rishigovindnair-web/mini-bluetooth-speaker/BOM.csv

Item | Part | Qty used | Pack size | Role | Must-match spec | Example source | Link | Approx price (USD) | CAD file | Notes
1 | Li-ion cell 18650 (Samsung INR18650-25R) | 1 | 1 | Battery | Flat-top, unprotected, max 18.4 x 65.0 mm | 18650BatteryStore (US) | https://www.18650batterystore.com/products/samsung-25r-18650 | 4.99 | cad/reference/05_cell_samsung_INR18650-25R.step | Buy cells from a battery dealer, not a marketplace: fakes with inflated capacity are common. Store ships in the US for about $5.
2 | Bluetooth amp board MH-M38 | 1 | 1 | Bluetooth receiver + 2 x 5 W amp | Must be the M38 (M18 and M28 have no amp). About 45 x 20 mm; the pocket is 45.6 x 20.6 mm | AliExpress (EGBO Store) | https://www.aliexpress.us/item/3256808177096535.html | 1.66 | cad/reference/03_amp_board_DFR0720_MH-M38.step | Pick the variant "M38 MICRO". The CAD is modelled on the DFRobot DFR0720, which is the same MH-M38 module.
3 | TP4056 USB-C charger with protection | 1 | 5 | Charging + battery protection | USB-C, about 28 x 17 mm, three chips on the board: TP4056 + DW01A + 8205A | AliExpress (Great IT electronic components) | https://www.aliexpress.us/item/2251832744326141.html | 1.83 | cad/reference/06_charger_module_TP4056_USB-C.step | Pick the variant "5PCS 18650 type-c". A board with only one chip has no battery protection; do not use it with this cell.
4 | Speaker driver 40 mm 4 ohm 3 W | 1 | 2 | Full-range driver | Round, 40 mm diameter, 20 mm tall or less, 4 ohm | AliExpress (Stationery world Store) | https://www.aliexpress.us/item/3256807819452623.html | 4.95 | cad/reference/04_driver_40mm_adafruit_3968.step | The seller's drawing shows 40 x 19 mm. Anything taller than 20 mm hits the cell. The second driver is a spare.
5 | Nickel strip 0.15 x 8 mm | 50 mm (two 25 mm tabs) | 10 m | Cell tabs | Pure nickel, 0.15 mm thick, 8 mm wide | AliExpress (Global-Dropshipping Store) | https://www.aliexpress.us/item/3256811494411014.html | 5.05 | cad/reference/08_nickel_tab_0.15x8x25mm.step | Pick the variant "0.15mm". Nickel-plated steel is cheaper but takes solder badly. Spot-weld the tabs to the cell.
6 | M2 x 8 mm self-tapping screws | 4 | 50 | Lid screws | M2, 8 mm long, self-tapping, head no wider than 4.2 mm | AliExpress (TINGGOO Official Store) | https://www.aliexpress.us/item/3256807588372372.html | 1.80 | cad/reference/07_screw_M2x8_self-tapping.step | Pick the variant "8mm/50pcs M2". The lid recesses are 4.4 mm across; if the heads are wider, use any M2 x 8 pan-head self-tapper instead.
7 | Slide switch SS12D00G4 | 1 | 50 | Power switch | SPDT, body about 8.6 x 3.6 x 3.5 mm, 4 mm lever | AliExpress | https://www.aliexpress.us/item/3256809209016852.html | 1.27 | cad/reference/09_slide_switch_SS12D00G4.step | Pick the variant "Handle length 4mm". It sits in the recess on the inside of the end wall with the lever through the slot.
8 | PLA or PETG filament | about 60 g |  | Enclosure | 1.75 mm | Any |  |  | cad/print/01_enclosure_base.stl; cad/print/02_enclosure_lid.stl | Base and lid are 56 cm3 of plastic if printed solid, so a normal print uses less.
9 | Hook-up wire 26-28 AWG | about 30 cm |  | Internal wiring | Stranded, red and black | Any
10 | Hot glue | a few sticks |  | Holds the boards and switch; seals the driver |  | Any
