rishigovindnair-web/mini-bluetooth-speaker/cad/assembly/00_full_assembly.step

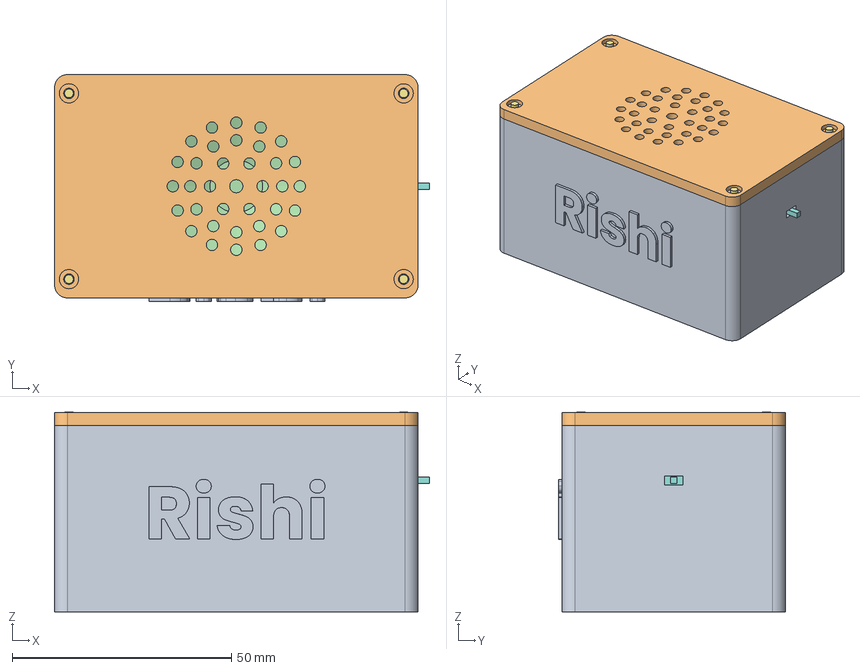
[picture p4: CAD file, 2026-10-26]
cad/assembly/00_full_assembly.step
85.6 x 51.8 x 45.6 mm
01_enclosure_base
02_enclosure_lid
03_amp_board_DFR0720_MH-M38
04_driver_40mm_adafruit_3968
05_cell_samsung_INR18650-25R
06_charger_module_TP4056_USB-C
07_screw_M2x8_1
07_screw_M2x8_2
07_screw_M2x8_3
07_screw_M2x8_4
09_slide_switch_SS12D00G4
