rishigovindnair-web/mini-bluetooth-speaker/cad/assembly/00_layout_flat_all_parts.step

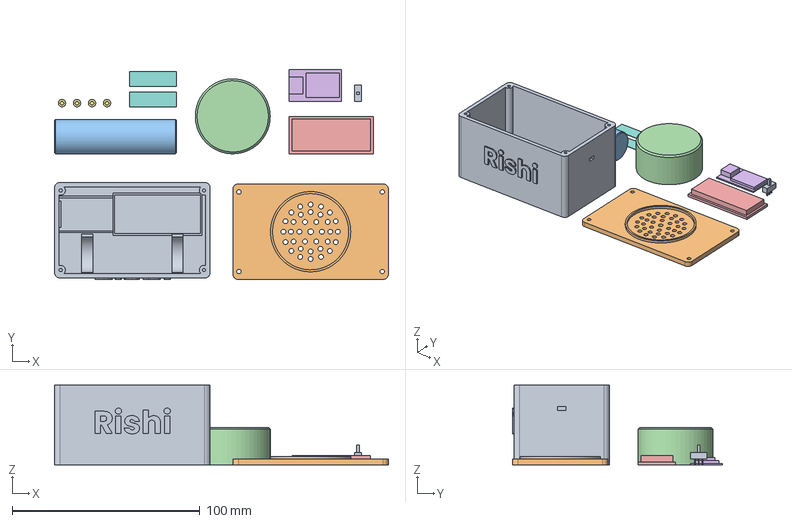
[picture p5: CAD file, 2026-10-26]
cad/assembly/00_layout_flat_all_parts.step
178.0 x 112.0 x 42.5 mm
01_enclosure_base
02_enclosure_lid_flipped
05_cell_samsung_INR18650-25R
04_driver_40mm_face_up
03_amp_board_DFR0720_MH-M38
06_charger_module_TP4056_USB-C
07_screw_M2x8_1
07_screw_M2x8_2
07_screw_M2x8_3
07_screw_M2x8_4
08_nickel_tab_25mm_1
08_nickel_tab_25mm_2
09_slide_switch_SS12D00G4
