rishigovindnair-web/mini-bluetooth-speaker/cad/print/02_enclosure_lid.step

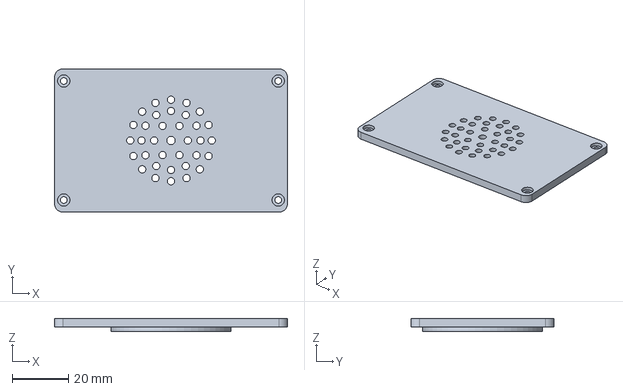
[picture p6: CAD file, 2026-10-26]
cad/print/02_enclosure_lid.step
83.0 x 51.0 x 4.50 mm
