rishigovindnair-web/mini-bluetooth-speaker/cad/reference/08_nickel_tab_0.15x8x25mm.step

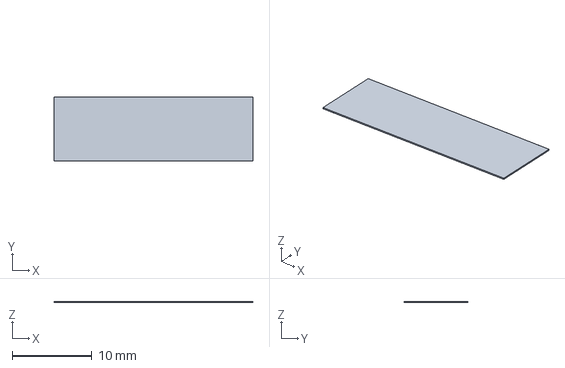
[picture p7: CAD file, 2026-10-26]
cad/reference/08_nickel_tab_0.15x8x25mm.step
25.0 x 8.00 x 0.15 mm
