rishigovindnair-web/mini-bluetooth-speaker/cad/print/01_enclosure_base.step

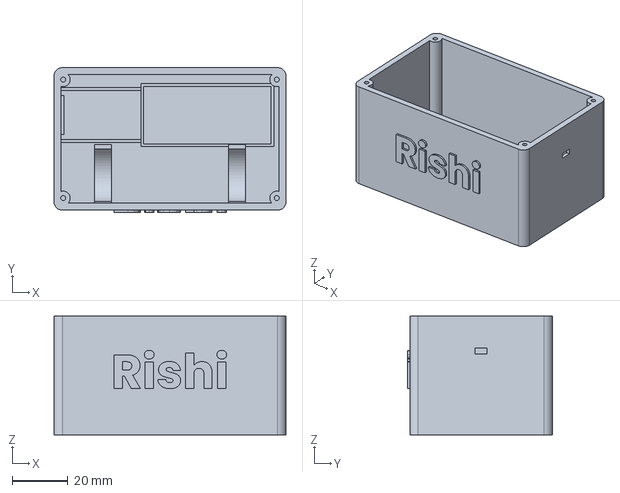
[picture p8: CAD file, 2026-10-26]
cad/print/01_enclosure_base.step
83.0 x 51.8 x 42.5 mm
