rishigovindnair-web/mini-bluetooth-speaker/cad/reference/03_amp_board_DFR0720_MH-M38.step

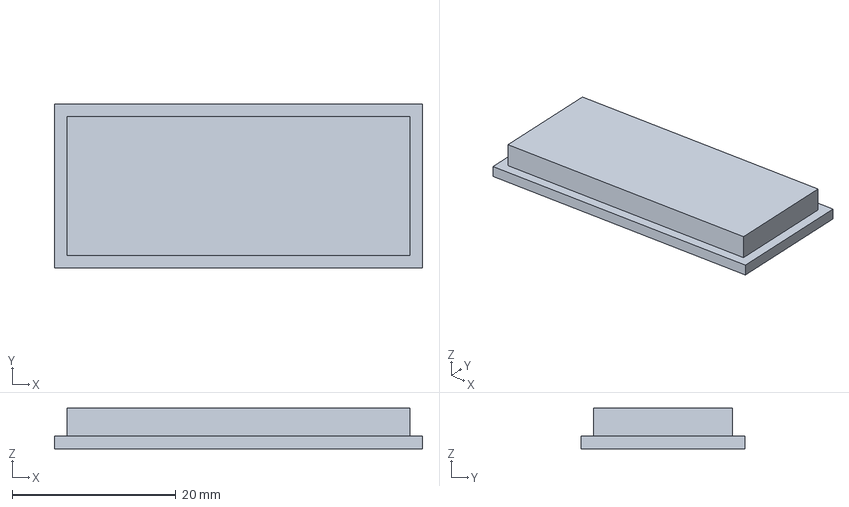
[picture p9: CAD file, 2026-10-26]
cad/reference/03_amp_board_DFR0720_MH-M38.step
45.0 x 20.0 x 5.00 mm
