rishigovindnair-web/mini-bluetooth-speaker/cad/reference/05_cell_samsung_INR18650-25R.step

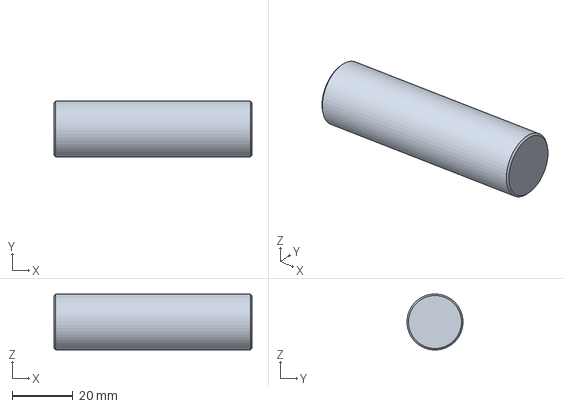
[picture p10: CAD file, 2026-10-26]
cad/reference/05_cell_samsung_INR18650-25R.step
65.0 x 18.4 x 18.4 mm
