rishigovindnair-web/mini-bluetooth-speaker/cad/reference/06_charger_module_TP4056_USB-C.step

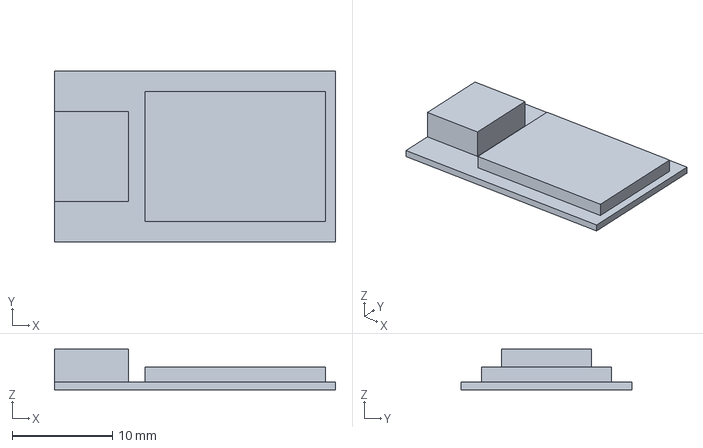
[picture p11: CAD file, 2026-10-26]
cad/reference/06_charger_module_TP4056_USB-C.step
28.0 x 17.0 x 4.06 mm
