rishigovindnair-web/mini-bluetooth-speaker/cad/reference/09_slide_switch_SS12D00G4.step

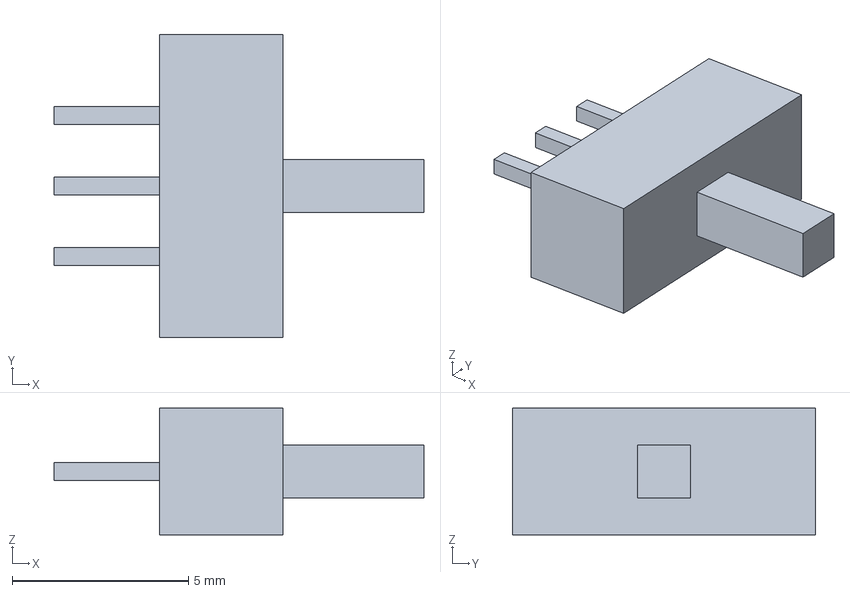
[picture p12: CAD file, 2026-10-26]
cad/reference/09_slide_switch_SS12D00G4.step
10.5 x 8.60 x 3.60 mm
