rishigovindnair-web/mini-bluetooth-speaker/cad/reference/04_driver_40mm_adafruit_3968.step

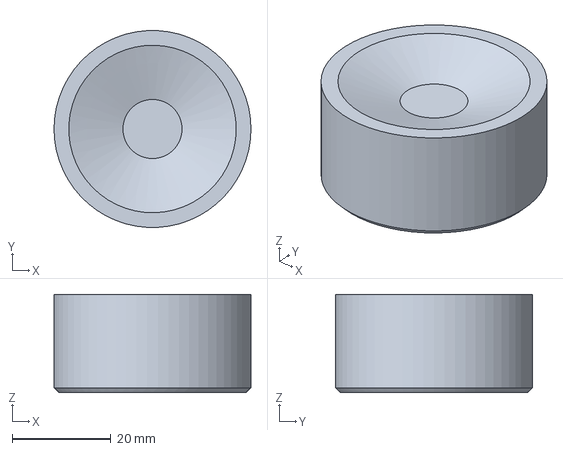
[picture p13: CAD file, 2026-10-26]
cad/reference/04_driver_40mm_adafruit_3968.step
40.0 x 39.9 x 20.0 mm
