rishigovindnair-web/mini-bluetooth-speaker/cad/reference/07_screw_M2x8_self-tapping.step

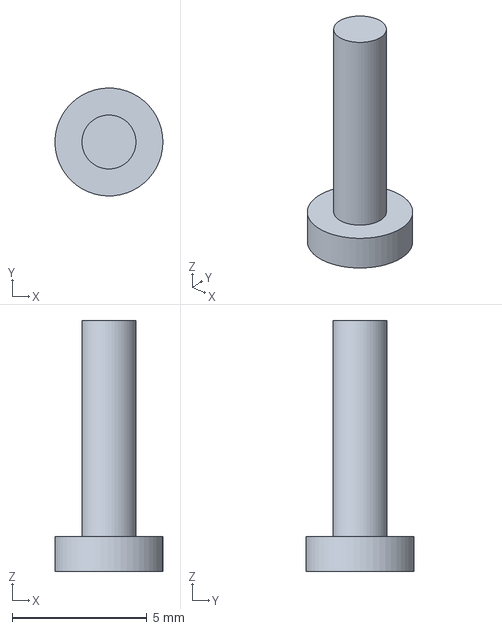
[picture p14: CAD file, 2026-10-26]
cad/reference/07_screw_M2x8_self-tapping.step
4.00 x 4.00 x 9.30 mm
