rishigovindnair-web/mini-bluetooth-speaker/(list of files, cad)

Other CAD files:
cad/print/01_enclosure_base.stl
cad/print/02_enclosure_lid.stl
