rishigovindnair-web/mini-bluetooth-speaker/hardware/wiring_schematic.pdf

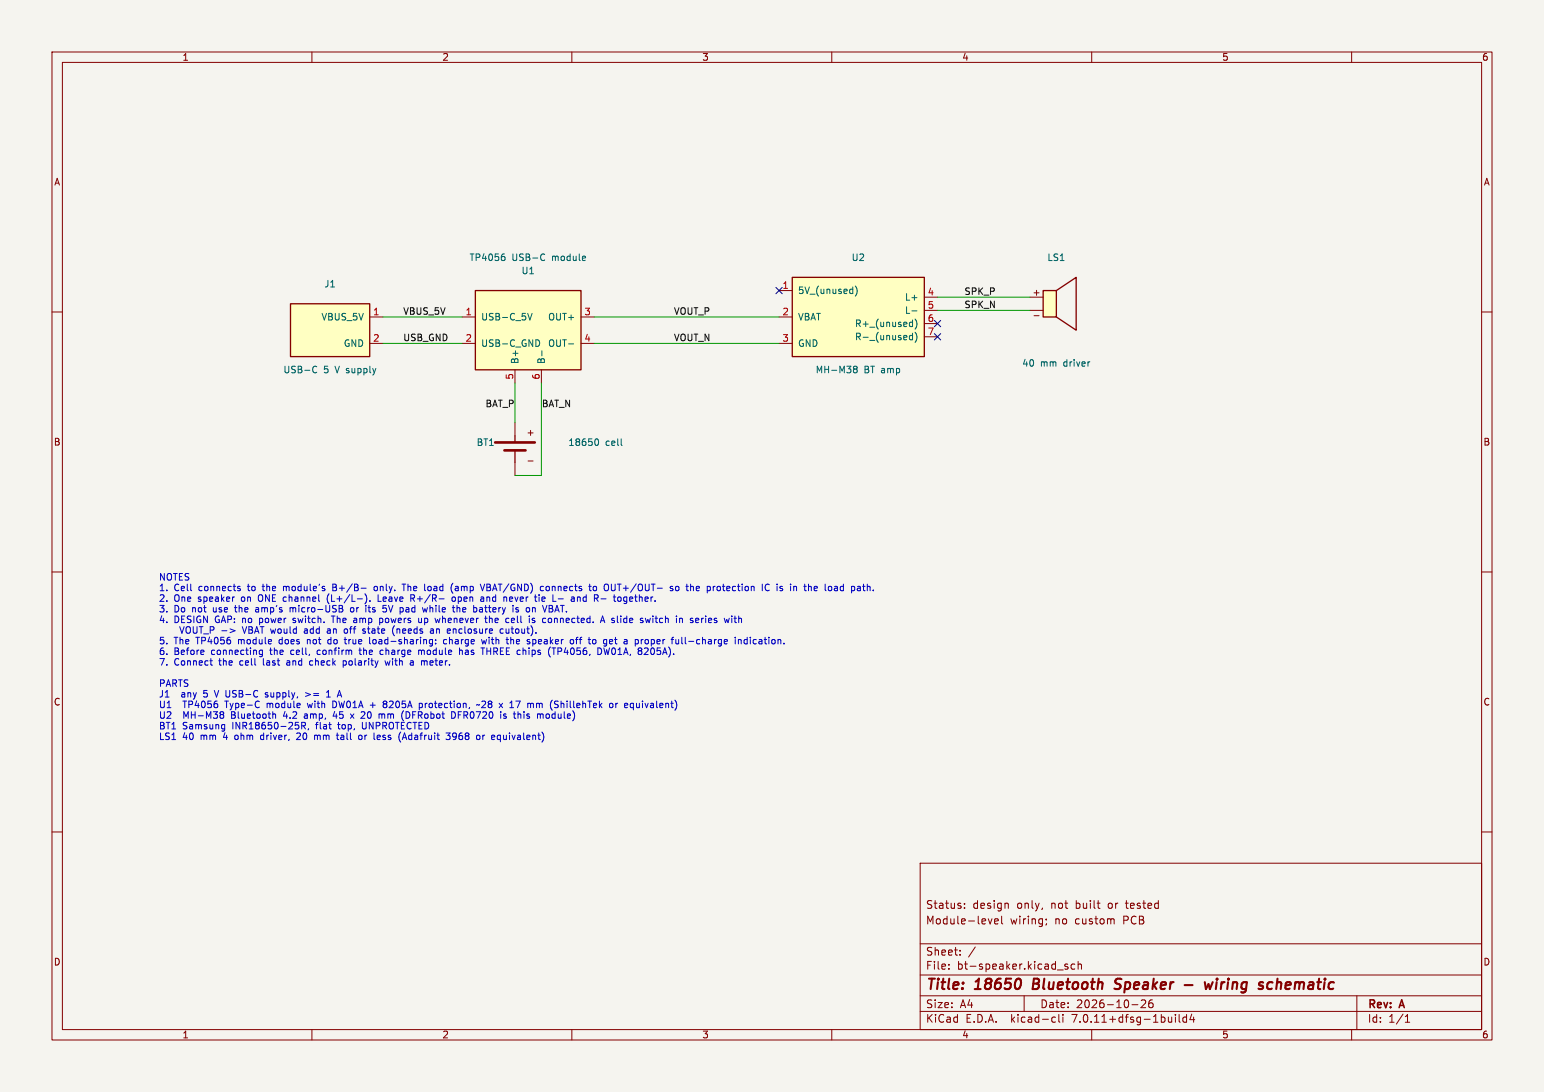
[picture p15: page 1]
