rishigovindnair-web/mini-bluetooth-speaker/hardware/kicad/bt-speaker.kicad_sch

## KiCad design hardware/kicad/bt-speaker.kicad_sch (2026-10-26)

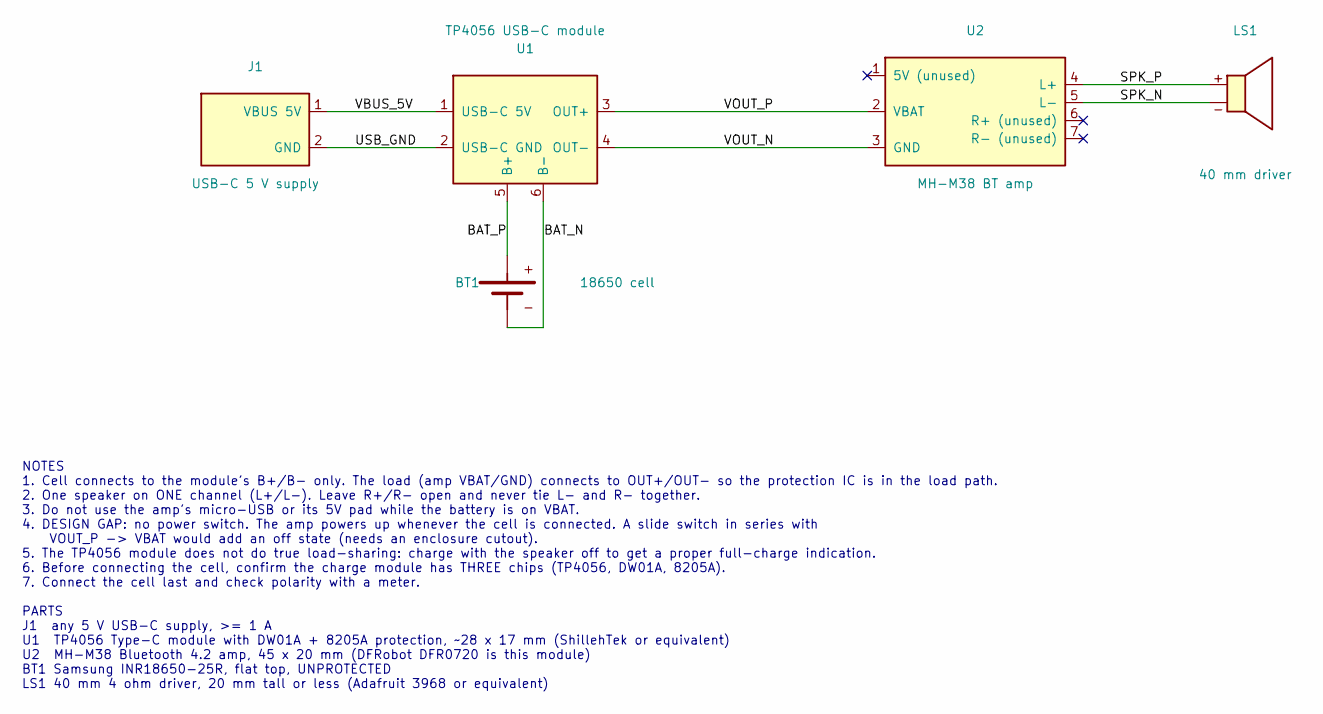
[picture p16: schematic bt-speaker.kicad_sch]

Parts:
BT1: 18650 cell
J1: USB-C 5 V supply
LS1: 40 mm driver
U1: TP4056 USB-C module
U2: MH-M38 BT amp

Connections:
BAT_N: BT1.2 (-), U1.6 (B-)
BAT_P: BT1.1 (+), U1.5 (B+)
SPK_N: LS1.2 (-), U2.5 (L-)
SPK_P: LS1.1 (+), U2.4 (L+)
USB_GND: J1.2 (GND), U1.2 (USB-C GND)
VBUS_5V: J1.1 (VBUS 5V), U1.1 (USB-C 5V)
VOUT_N: U1.4 (OUT-), U2.3 (GND)
VOUT_P: U1.3 (OUT+), U2.2 (VBAT)

Notes on the sheet:
NOTES 1. Cell connects to the module's B+/B- only. The load (amp VBAT/GND) connects to OUT+/OUT- so the protection IC is in the load path. 2. One speaker on ONE channel (L+/L-). Leave R+/R- open and never tie L- and R- together. 3. Do not use the amp's micro-USB or its 5V pad while the battery is o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
