rishigovindnair-web/mini-bluetooth-speaker/(commit log)

2026-10-26 Add README and BOM
    [BOM.csv]
2026-10-26 Add printable enclosure files
    [01_enclosure_base.step, 01_enclosure_base.stl, 02_enclosure_lid.step, 02_enclosure_lid.stl]
2026-10-26 Add assembly files
    [00_full_assembly.step, 00_layout_flat_all_parts.step]
2026-10-26 Add reference part models
    [03_amp_board_DFR0720_MH-M38.step, 04_driver_40mm_adafruit_3968.step, 05_cell_samsung_INR18650-25R.step, 06_charger_module_TP4056_USB-C.step, 07_screw_M2x8_self-tapping.step, 08_nickel_tab_0.15x8x25mm.step, 09_slide_switch_SS12D00G4.step]
2026-10-26 Add wiring diagram
2026-10-26 README: add schematic, CAD source and firmware sections
2026-10-26 Add parametric CAD source
2026-10-26 Add schematic exports and wiring list
    [wiring.csv]
2026-10-26 Add KiCad schematic source
    [bt-speaker.kicad_sch]
